jpwright/facebook-squared/schematic/schematic.png

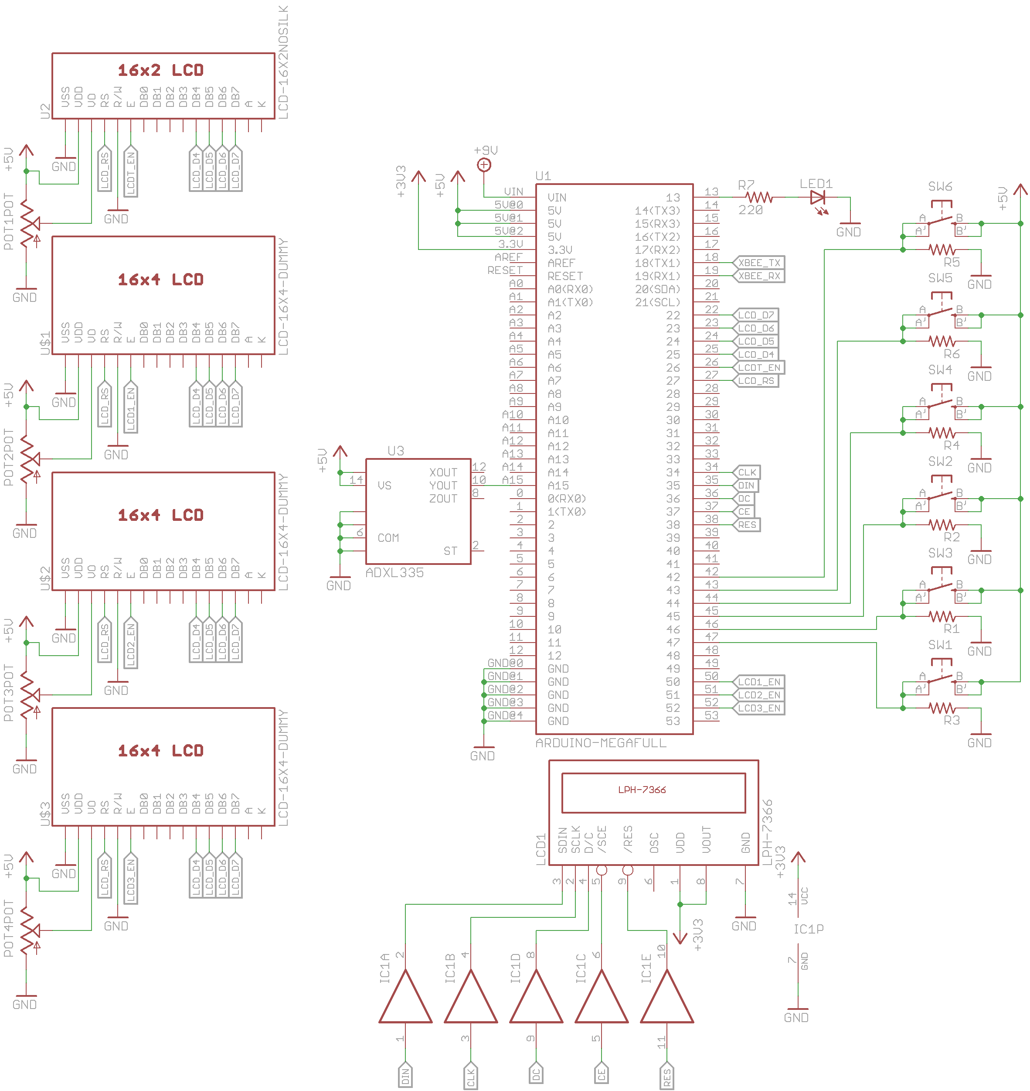
schematic/schematic.png
