jpwright/facebook-squared/schematic/facebook-squared-schematic.sch

## EAGLE design schematic/facebook-squared-schematic.sch (2012-07-28)

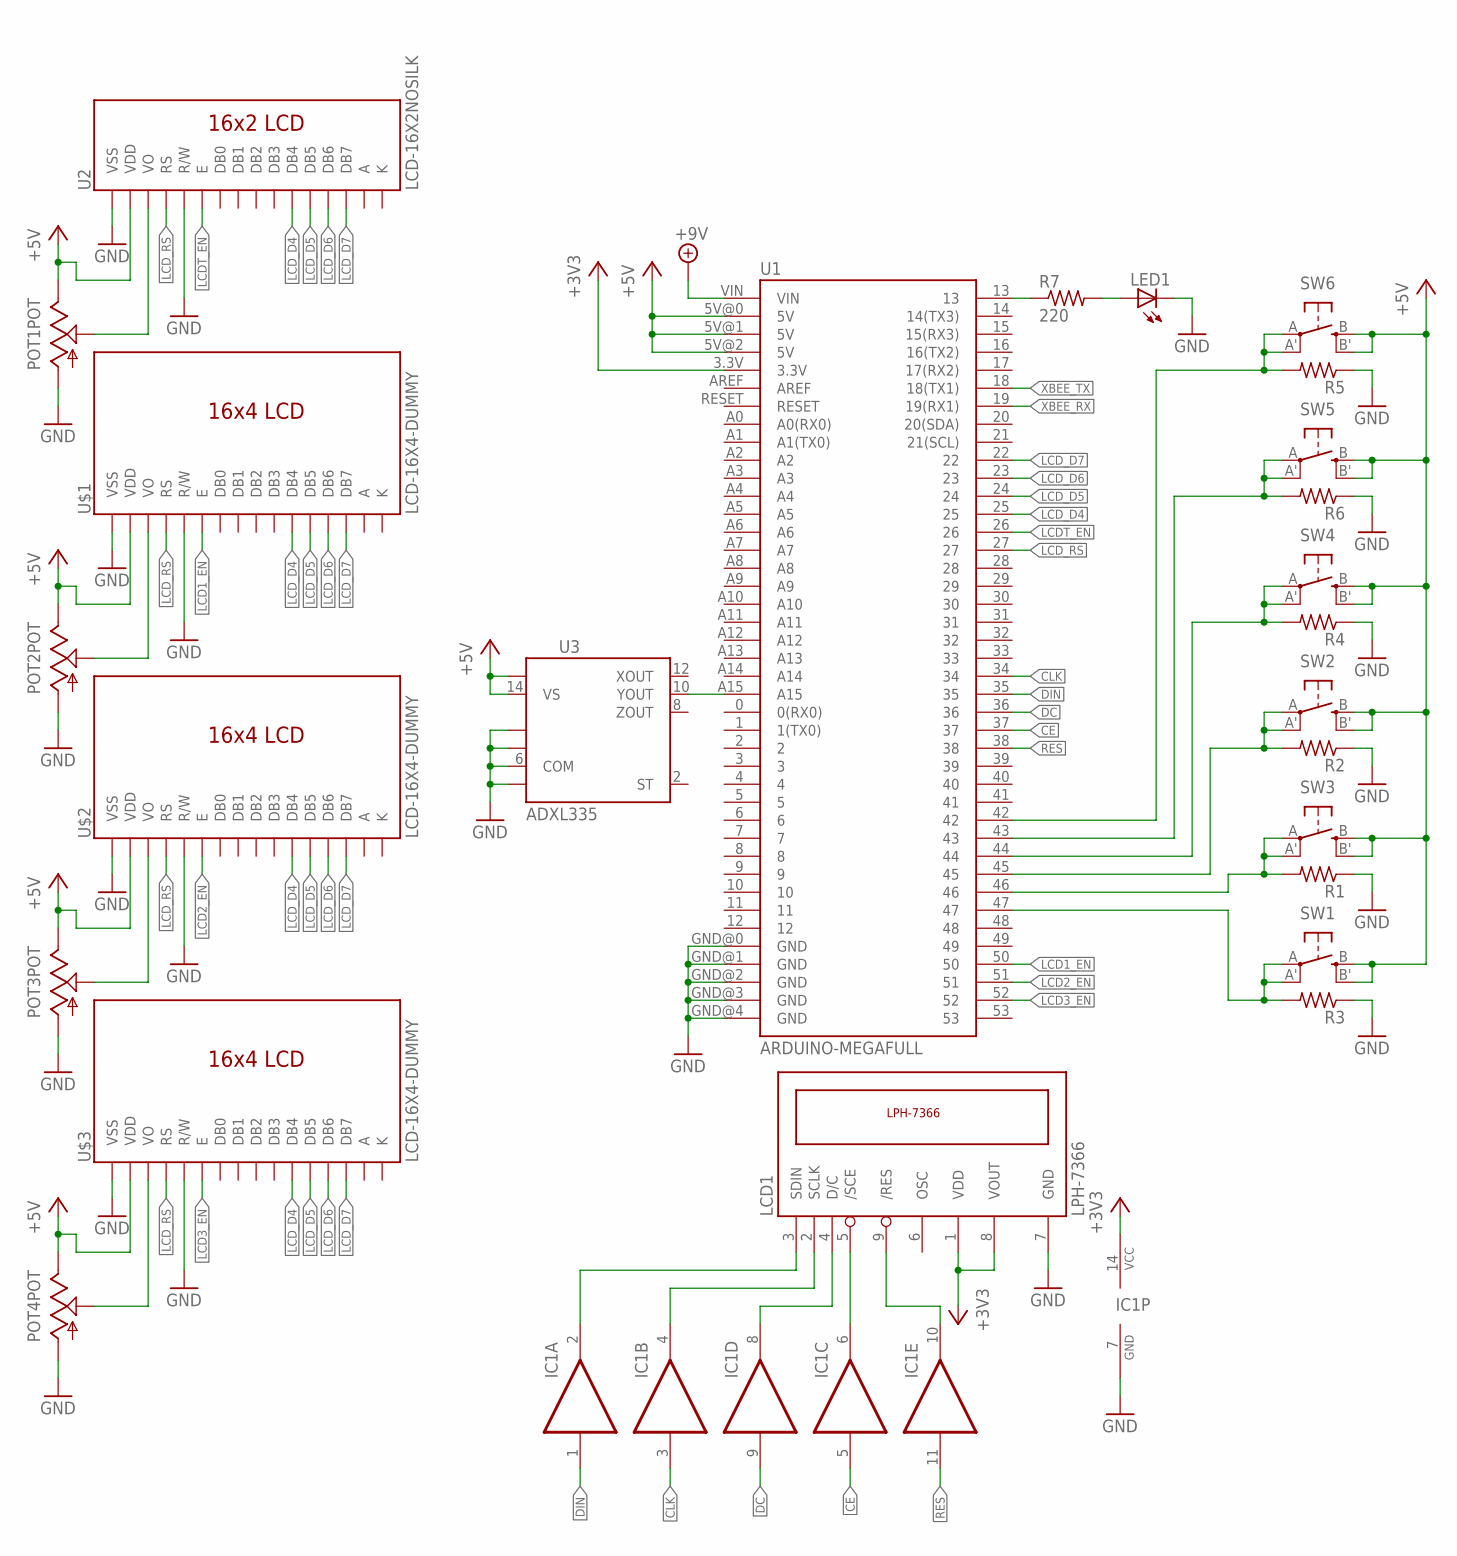
[picture p2: schematic facebook-squared-schematic.sch]

Parts:
IC1: 74LS07N; DIL14
LCD1: LPH-7366
LED1: LED5MM
POT1, POT2, POT3, POT4: THUMBPOTV; THUMBWHEELV
R1, R2, R3, R4, R5, R6: R-US_0309/12; 0309/12
R7: 220; 0309/12
SW1, SW2, SW3, SW4, SW5, SW6: SPST_TACT-EVQQ2; EVQ-Q2
U1: ARDUINO-MEGAFULL; ARDUINO_MEGA
U2: LCD-16X2NOSILK; LCD-16X2_NOSILK
U3: ADXL335; LFCSP-16
U$1, U$2, U$3: LCD-16X4-DUMMY; LCD-16X2_NOSILK

Connections:
+3V3: IC1.14 (VCC), LCD1.1 (VDD), LCD1.8 (VOUT), U1.3.3V
+5V: POT1.E, POT2.E, POT3.E, POT4.E, SW1.B (S), SW1.B' (S1), SW2.B (S), SW2.B' (S1), SW3.B (S), SW3.B' (S1), SW4.B (S), SW4.B' (S1), SW5.B (S), SW5.B' (S1), SW6.B (S), SW6.B' (S1), U1.5V@0 (5V), U1.5V@1 (5V), U1.5V@2 (5V), U2.2 (VDD), U3.14 (VS), U3.15 (VS), U$1.2 (VDD), U$2.2 (VDD), U$3.2 (VDD)
+9V: U1.VIN
CE: IC1.5 (I), U1.37
CLK: IC1.3 (I), U1.34
DC: IC1.9 (I), U1.36
DIN: IC1.1 (I), U1.35
GND: IC1.7 (GND), LCD1.7 (GND), LED1.K (C), POT1.A, POT2.A, POT3.A, POT4.A, R1.1, R2.1, R3.1, R4.1, R5.1, R6.1, U1.GND@0 (GND), U1.GND@1 (GND), U1.GND@2 (GND), U1.GND@3 (GND), U1.GND@4 (GND), U2.1 (VSS), U2.5 (R/W), U3.3 (COM), U3.5 (COM), U3.6 (COM), U3.7 (COM), U$1.1 (VSS), U$1.5 (R/W), U$2.1 (VSS), U$2.5 (R/W), U$3.1 (VSS), U$3.5 (R/W)
LCD1_EN: U1.50, U$1.6 (E)
LCD2_EN: U1.51, U$2.6 (E)
LCD3_EN: U1.52, U$3.6 (E)
LCDT_EN: U1.26, U2.6 (E)
LCD_D4: U1.25, U2.11 (DB4), U$1.11 (DB4), U$2.11 (DB4), U$3.11 (DB4)
LCD_D5: U1.24, U2.12 (DB5), U$1.12 (DB5), U$2.12 (DB5), U$3.12 (DB5)
LCD_D6: U1.23, U2.13 (DB6), U$1.13 (DB6), U$2.13 (DB6), U$3.13 (DB6)
LCD_D7: U1.22, U2.14 (DB7), U$1.14 (DB7), U$2.14 (DB7), U$3.14 (DB7)
LCD_RS: U1.27, U2.4 (RS), U$1.4 (RS), U$2.4 (RS), U$3.4 (RS)
unnamed: POT1.S, U2.3 (VO)
unnamed: POT2.S, U$1.3 (VO)
unnamed: POT3.S, U$2.3 (VO)
unnamed: POT4.S, U$3.3 (VO)
unnamed: U1.A15, U3.10 (YOUT)
unnamed: R7.1, U1.13
unnamed: LED1.A, R7.2
unnamed: R4.2, SW4.A, SW4.A' (P1), U1.44
unnamed: R6.2, SW5.A, SW5.A' (P1), U1.43
unnamed: R5.2, SW6.A, SW6.A' (P1), U1.42
unnamed: R3.2, SW1.A, SW1.A' (P1), U1.47
unnamed: R1.2, SW3.A, SW3.A' (P1), U1.46
unnamed: R2.2, SW2.A, SW2.A' (P1), U1.45
unnamed: IC1.4 (O), LCD1.2 (SCLK)
unnamed: IC1.2 (O), LCD1.3 (SDIN)
unnamed: IC1.8 (O), LCD1.4 (D/C)
unnamed: IC1.6 (O), LCD1.5 (/SCE)
unnamed: IC1.10 (O), LCD1.9 (/RES)
RES: IC1.11 (I), U1.38
XBEE_RX: U1.19 (19(RX1))
XBEE_TX: U1.18 (18(TX1))
