jpwright/facebook-squared/(commit log)

2012-07-21 init arduino program, developed Serial comm protocol in readme.md
2012-07-21 Arduino Debug and XBee working
2012-07-22 All 4 LCDs working, Serial protocol expanded, Debounced Buttons added
2012-07-22 updating arduino
2012-07-22 button debounce code, custom chars, serial comm protocol partially implemented, debugs added, GLCD interface code added
2012-07-22 detection and debounce for all buttons completed
2012-07-22 accelerometer repeat readings fixed
    [book_interface.ino]
2012-07-22 All Arduino code is finalized
2012-07-28 Accelerometer Calibration Adjusted, Readme Updated, Schematic Added
    [facebook-squared-schematic.sch]
